PetterKokkim/MMP-Robotfish/Documents/fishtail printed.jpg

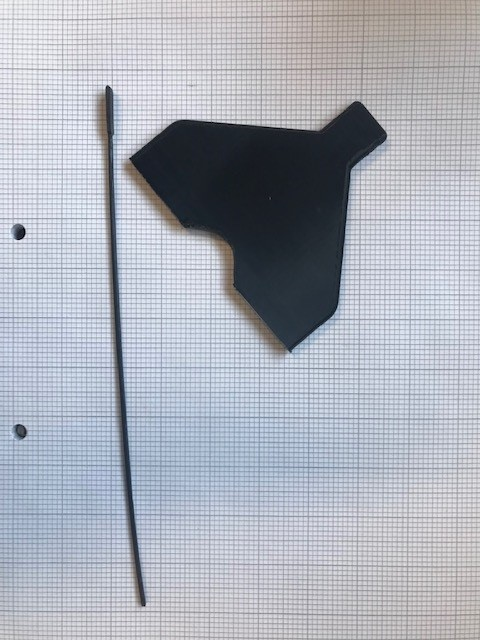
Documents/fishtail printed.jpg
