PetterKokkim/MMP-Robotfish/Documents/fishtail printed crop.jpg

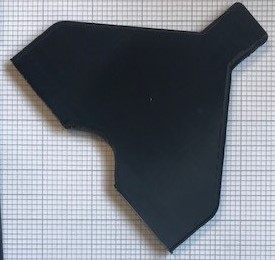
Documents/fishtail printed crop.jpg
