PetterKokkim/MMP-Robotfish/README.md

# MMP-Robotfish
Major Project final year at Aberyswyth University
