PetterKokkim/MMP-Robotfish/Documents/Hardware list.txt

https://www.amazon.co.uk/Crystal-Plastic-Stackable-Organizing-Container/dp/B08W5456VS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
https://www.robotshop.com/en/arduino-uno-r3-usb-microcontroller.html
https://www.robotshop.com/en/dc-planetary-geared-motor-with-encoder-diameter-36mm-12v-182rpm.html
https://www.robotshop.com/en/full-size-bare-breadboard-830-tie-point.html
https://www.robotshop.com/en/65-22-gauge-assorted-jumper-wires.html
