PetterKokkim/MMP-Robotfish/Documents/DM542 Pulse rev.PNG

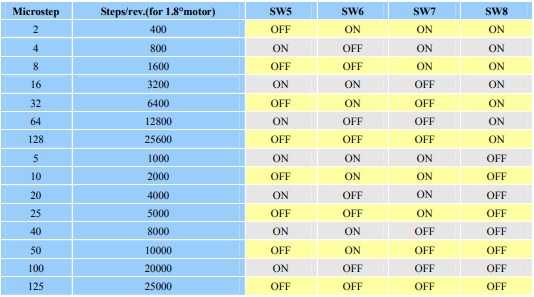
Documents/DM542 Pulse rev.PNG
