PetterKokkim/MMP-Robotfish/Documents/Fishtail.png

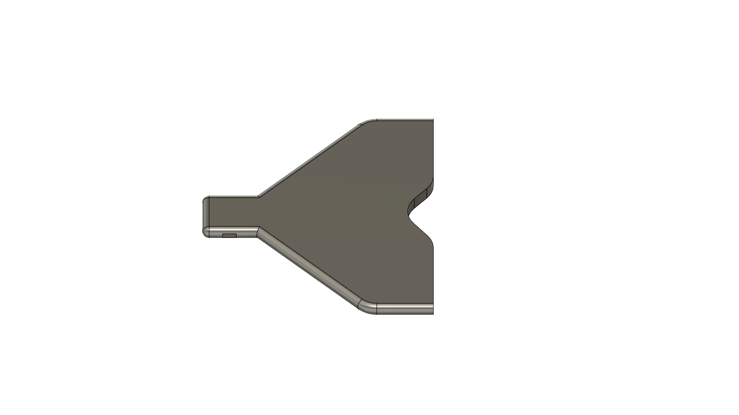
Documents/Fishtail.png
