PetterKokkim/MMP-Robotfish/Documents/MMP Fish Tail Platform v7.png

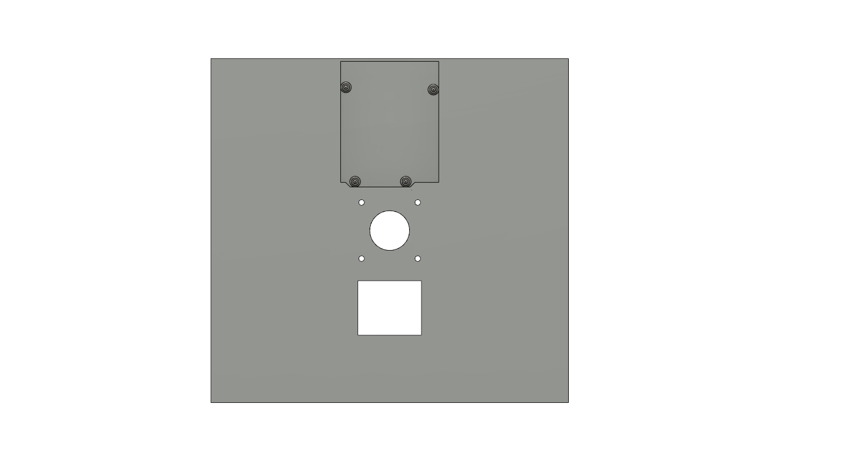
Documents/MMP Fish Tail Platform v7.png
