PetterKokkim/MMP-Robotfish/Documents/Platform_image0.jpg

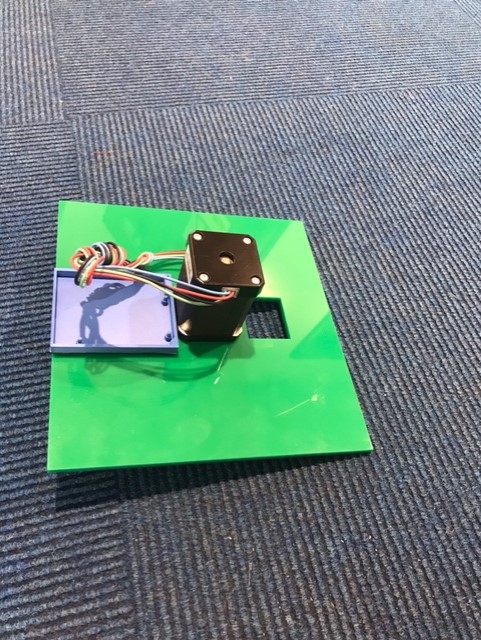
Documents/Platform_image0.jpg
