PetterKokkim/MMP-Robotfish/Documents/Platform_image1.jpg

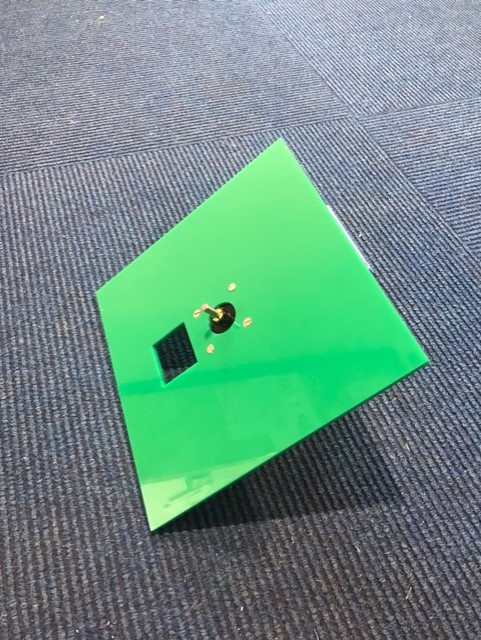
Documents/Platform_image1.jpg
