PetterKokkim/MMP-Robotfish/(list of files, cad)

Other CAD files:
Fusion 360 Models/Arduino_uno.6df525b0-a0fc-4683-8e1a-4d70c617ad71.f3d
Fusion 360 Models/Fishtail v3.f3d
