PetterKokkim/MMP-Robotfish/(list of files, drawings)

Other design files:
Documents/Schematics.fzz
