PetterKokkim/MMP-Robotfish/(commit log)

2022-02-25 3D models and etc
    [Arduino_uno.6df525b0-a0fc-4683-8e1a-4d70c617ad71.f3d]
2022-04-18 Create sketch_apr18a.ino
    Started arduino program
2022-05-02 Added another stepper
2022-05-04 Fixed code and more on Report
    [sketch_apr18a.ino]
